ashleyjr/Motor/hw/prints/trials/20201205_flywheel/notes.txt

To print use 0.2 with 50 infill 60C bed heat.

This stops the part lifting at the edges.
