ashleyjr/Motor/hw/prints/trials/20201114_pinned_bearing/pinned_bearing.stl

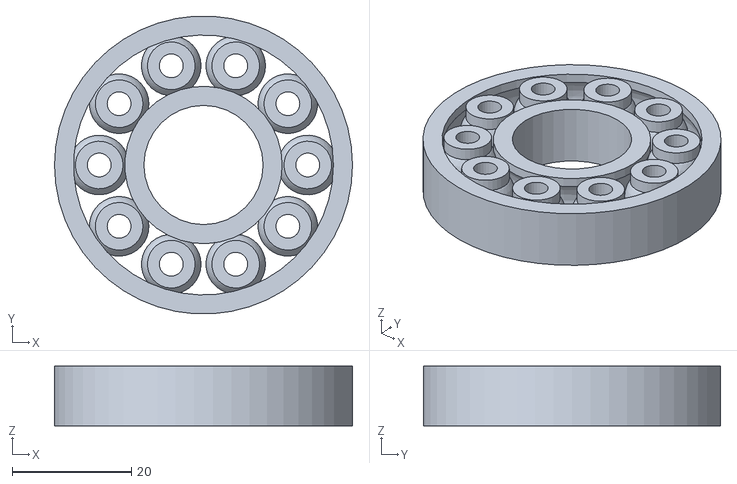
[picture p2: CAD file, 2020-11-15]
hw/prints/trials/20201114_pinned_bearing/pinned_bearing.stl
50.0 x 49.9 x 10.0
