ashleyjr/Motor/hw/prints/trials/20201115_hourglass_cups/hourglass_cups.stl

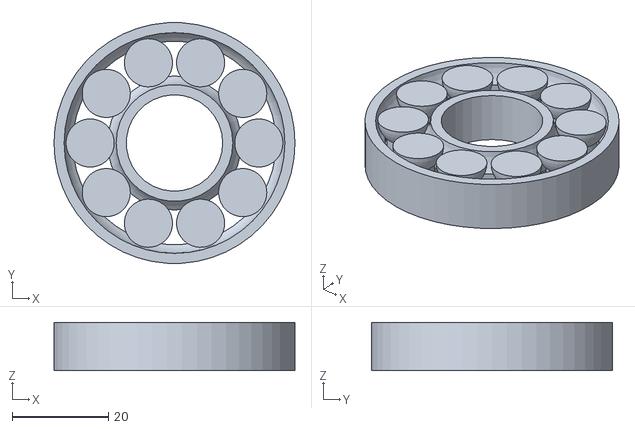
[picture p3: CAD file, 2020-11-16]
hw/prints/trials/20201115_hourglass_cups/hourglass_cups.stl
50.0 x 49.9 x 10.0
