ashleyjr/Motor/hw/prints/trials/20201117_grooves/grooves.stl

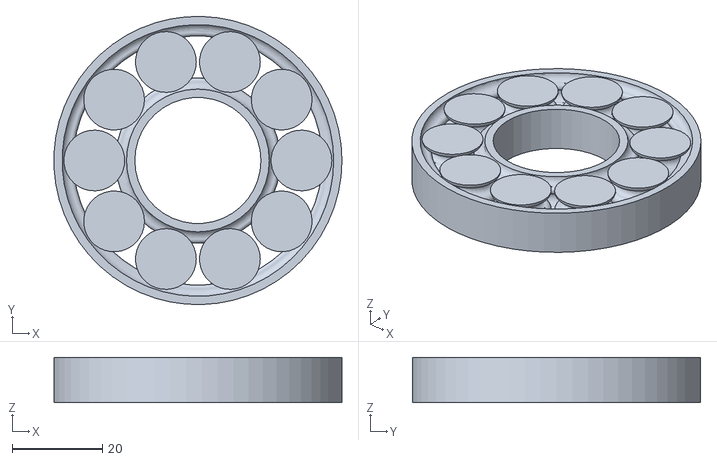
[picture p4: CAD file, 2020-11-19]
hw/prints/trials/20201117_grooves/grooves.stl
64.0 x 64.0 x 10.0
