ashleyjr/Motor/hw/prints/trials/20201119_shaft/shaft.stl

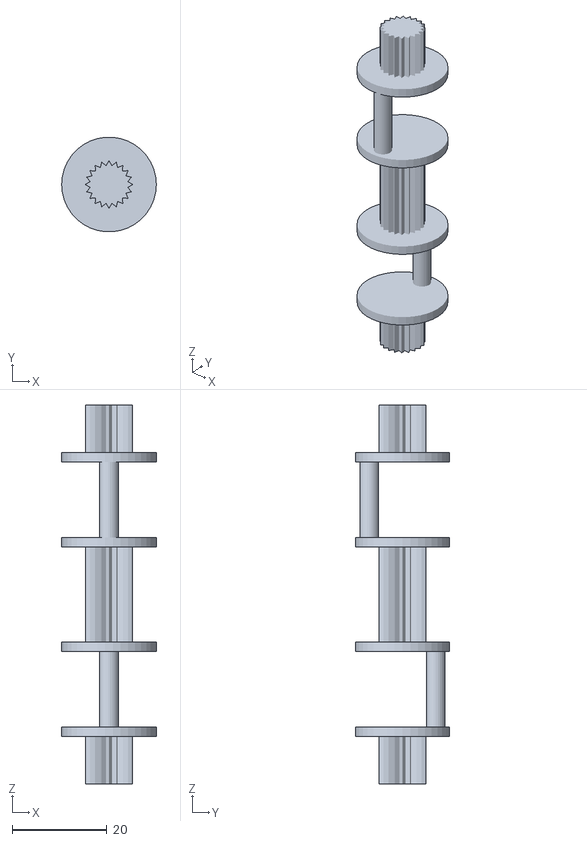
[picture p5: CAD file, 2020-11-20]
hw/prints/trials/20201119_shaft/shaft.stl
20.0 x 19.9 x 80.0
