ashleyjr/Motor/hw/prints/trials/20201121_hoop/hoop.stl

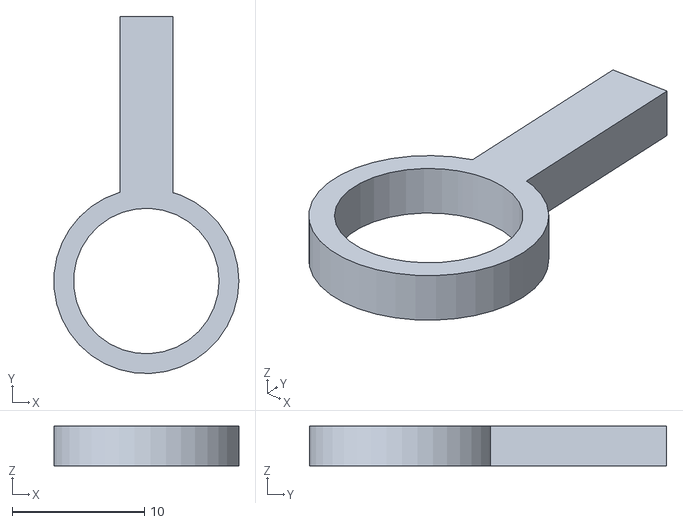
[picture p6: CAD file, 2020-11-21]
hw/prints/trials/20201121_hoop/hoop.stl
14.0 x 27.0 x 3.00
