ashleyjr/Motor/hw/prints/trials/20201121_locked_bearing/300um.stl

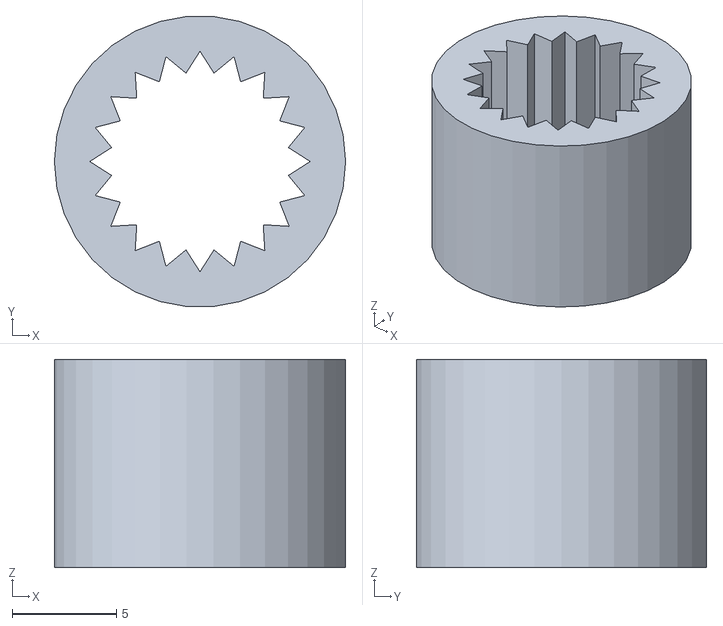
[picture p7: CAD file, 2020-11-21]
hw/prints/trials/20201121_locked_bearing/300um.stl
14.0 x 13.9 x 10.0
