ashleyjr/Motor/hw/prints/trials/20201121_sine_shaft/sine_shaft.stl

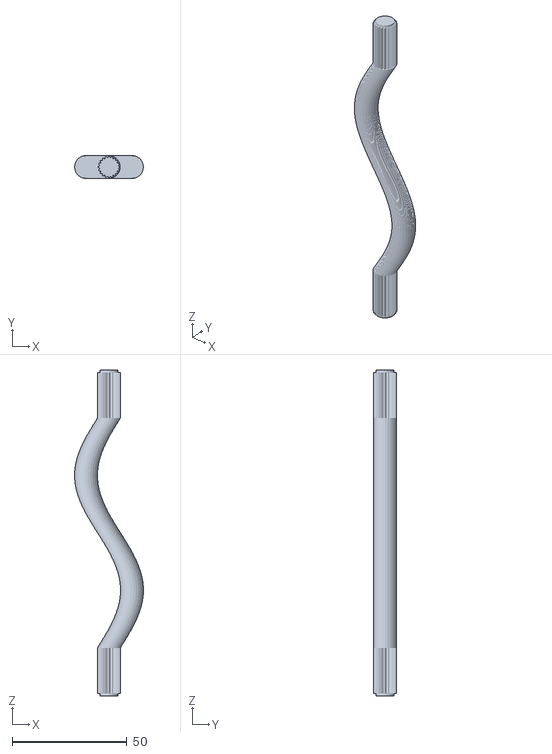
[picture p8: CAD file, 2020-12-08]
hw/prints/trials/20201121_sine_shaft/sine_shaft.stl
30.0 x 10.0 x 142.0
