ashleyjr/Motor/hw/prints/trials/20201123_side/side.stl

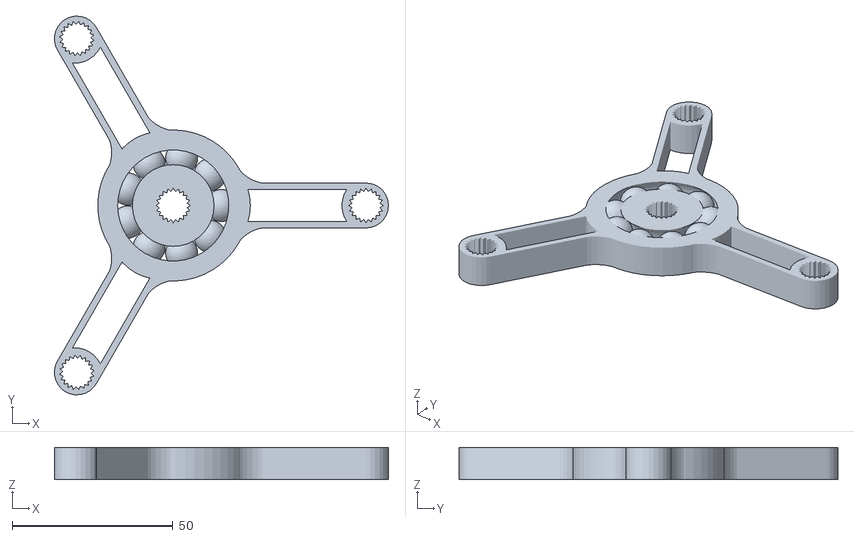
[picture p9: CAD file, 2020-12-02]
hw/prints/trials/20201123_side/side.stl
104.0 x 117.9 x 10.0
