ashleyjr/Motor/hw/prints/trials/20201125_shaft/shaft.stl

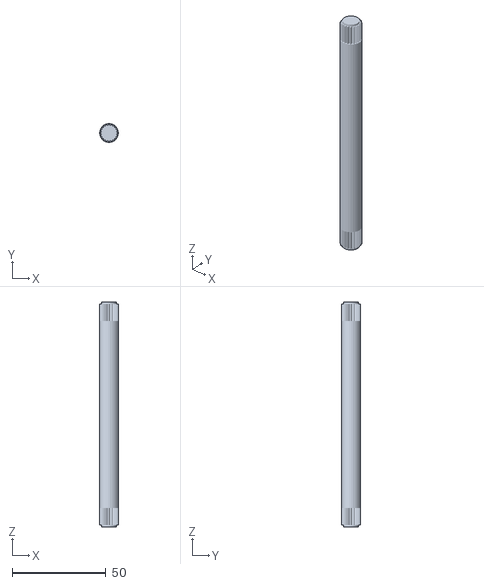
[picture p10: CAD file, 2020-11-25]
hw/prints/trials/20201125_shaft/shaft.stl
10.0 x 10.0 x 120.0
