ashleyjr/Motor/hw/prints/trials/20201127_solenoid/solenoid.stl

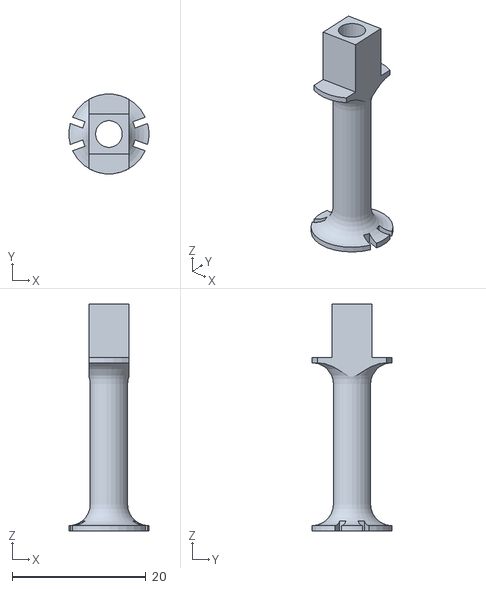
[picture p11: CAD file, 2020-12-07]
hw/prints/trials/20201127_solenoid/solenoid.stl
12.0 x 12.0 x 34.0
