ashleyjr/Motor/hw/prints/trials/20201129_hinge/hinge.stl

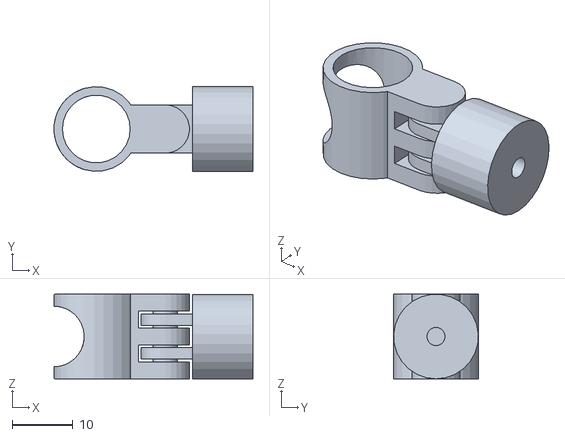
[picture p12: CAD file, 2020-12-10]
hw/prints/trials/20201129_hinge/hinge.stl
32.9 x 14.0 x 14.0
