ashleyjr/Motor/hw/prints/trials/20201201_crank/crank.stl

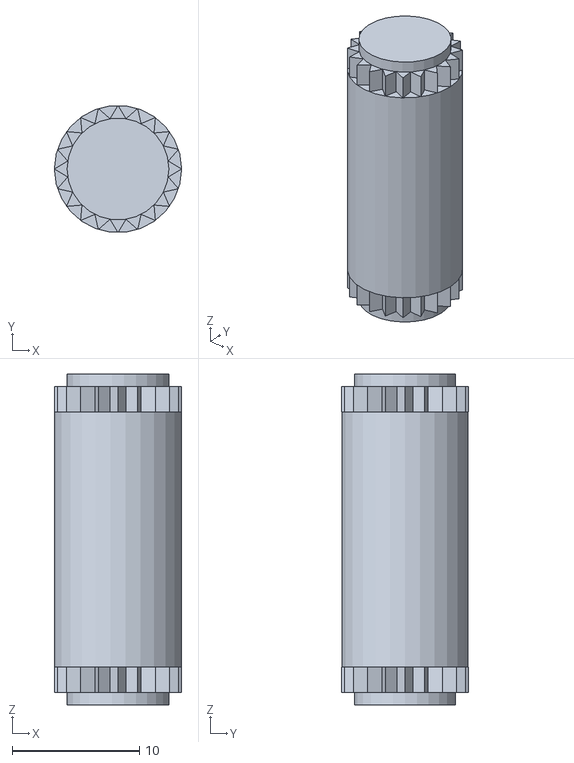
[picture p13: CAD file, 2020-12-01]
hw/prints/trials/20201201_crank/crank.stl
10.0 x 10.0 x 26.0
