ashleyjr/Motor/hw/prints/trials/20201201_crank_plate/crank_plate.stl

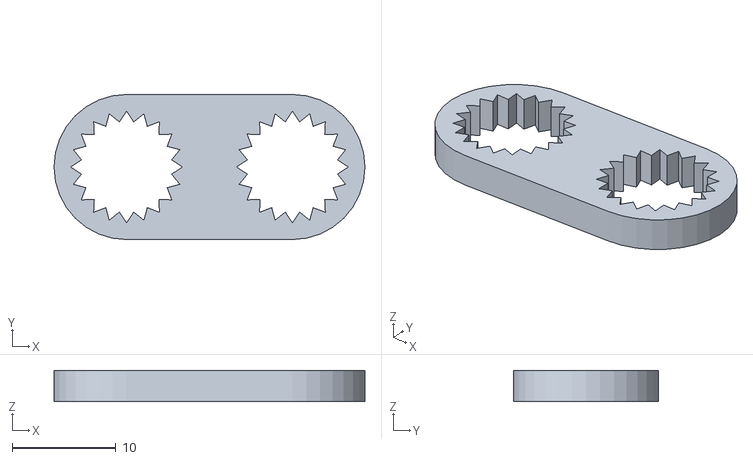
[picture p14: CAD file, 2020-12-01]
hw/prints/trials/20201201_crank_plate/crank_plate.stl
30.0 x 14.0 x 3.00
