ashleyjr/Motor/hw/prints/trials/20201202_top_shaft/top_shaft.stl

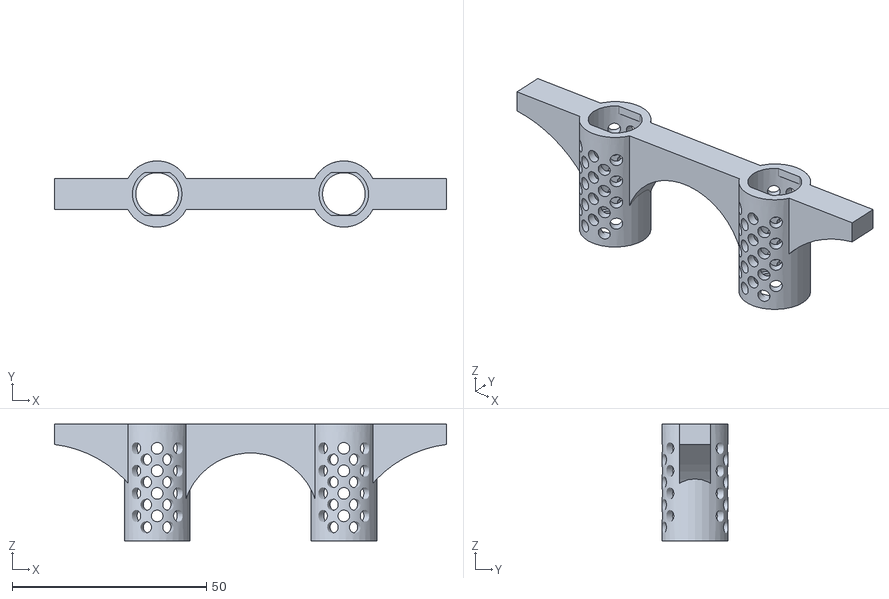
[picture p15: CAD file, 2020-12-07]
hw/prints/trials/20201202_top_shaft/top_shaft.stl
100.8 x 17.0 x 30.0
