ashleyjr/Motor/hw/prints/trials/20201205_flywheel/flywheel.stl

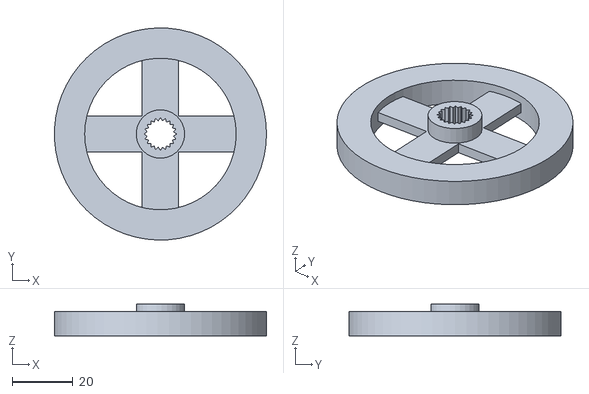
[picture p16: CAD file, 2020-12-10]
hw/prints/trials/20201205_flywheel/flywheel.stl
70.0 x 70.0 x 10.5
