ashleyjr/Motor/hw/prints/trials/20201207_holder/holder.stl

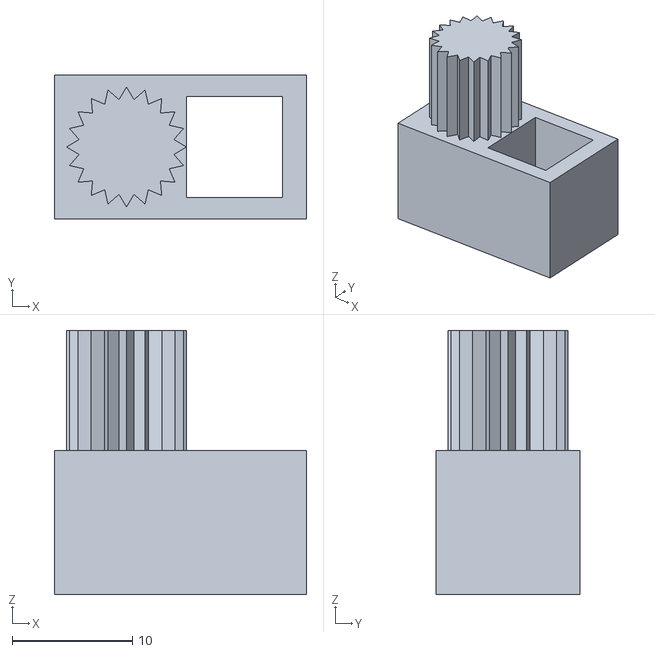
[picture p17: CAD file, 2020-12-08]
hw/prints/trials/20201207_holder/holder.stl
21.0 x 12.0 x 22.0
