ashleyjr/Motor/hw/prints/trials/20201112_bearing_gap/0250um.stl

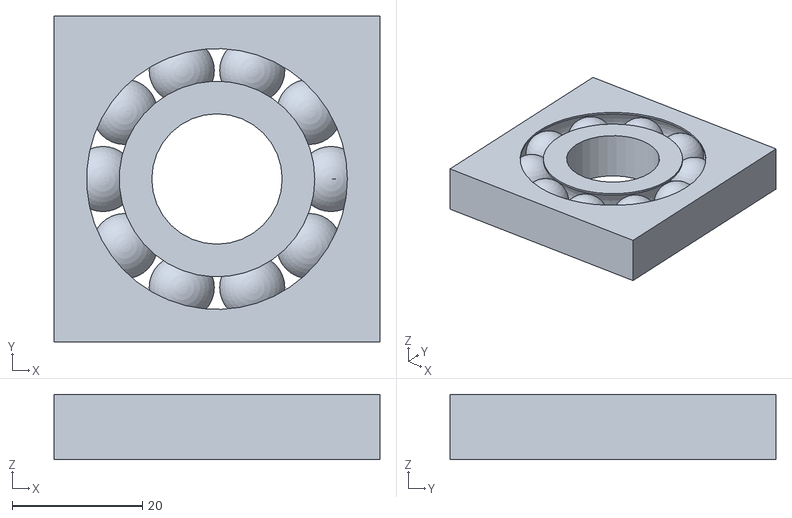
[picture p18: CAD file, 2020-11-12]
hw/prints/trials/20201112_bearing_gap/0250um.stl
50.0 x 50.0 x 10.0
