ashleyjr/Motor/hw/prints/trials/20201127_solenoid/2000um.stl

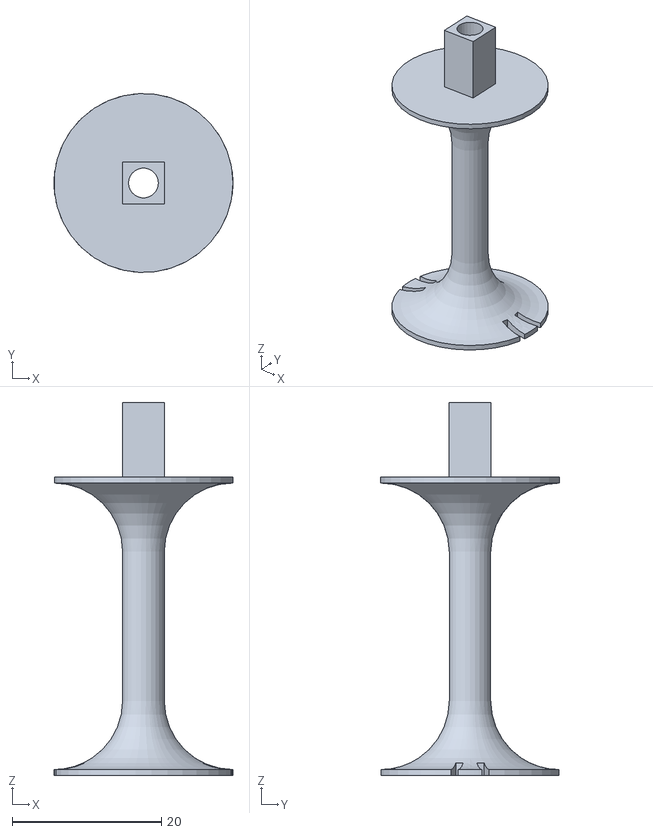
[picture p19: CAD file, 2020-12-01]
hw/prints/trials/20201127_solenoid/2000um.stl
24.0 x 24.0 x 50.0
