ashleyjr/Motor/(list of files, cad)

Other CAD files:
hw/prints/trials/20201116_rollers/rollers.stl
hw/prints/trials/20201116_track/track.stl
hw/prints/trials/20201121_locked_bearing/200um.stl
hw/prints/trials/20201112_bearing_gap/0500um.stl
hw/prints/trials/20201121_locked_bearing/100um.stl
hw/prints/trials/20201112_bearing_gap/0750um.stl
