ashleyjr/Motor/hw/prints/trials/20201129_hinge/notes.txt

-
   - Printed
 
      - Ender 5 Pro
      - PLA
      - 0.4mm nozzle
      - 0.12 Layer Height (high
      - 100% infill
      - No support
 
   - Outcome

      - Great print, hinges fine and the overhang is ok
      - Internal radius is too small for expected plunger so change to 5mm radius and try again
      - Prints well no in smaller size
         - Key to have about 3 layer between piston fins and shaft fins to the hinge does not get stuck
      
      - Tight piston end - could be tighter
      - Cut half cylinder out of front - could be smaller
