ashleyjr/Motor/hw/prints/trials/20201123_side/notes.txt

-
   - Printed
 
      - Ender 5 Pro
      - PLA
      - 0.4mm nozzle
      - 0.12 Layer Height (super)
      - 100% infill 
 
   - Outcome

      - Printed 0.12 at edge of bed but stared to lift away from the heated centre
      - Moved to middle of bed and 0.2 layer height (still 100% infill)

         - And change from Green (stringy) to black

      - Moved to 80 deg bed and printed wihtout lifting

         - Add fillets to edges
         - Make gaps bigger for stars
         - Make holes to save on print time
         - Printed 2 at 0.16, 100% with 80deg bed

      - Increased gap 
         
         - Try printy at 0.12
         - Also curved punches

      - Bearings dettached at 0.12 trying again at 0.16
      - Bearing still dettached so must be bearing gap
