ashleyjr/Motor/hw/prints/trials/20201125_shaft/notes.txt

-
   - Printed
 
      - Ender 5 Pro
      - PLA
      - 0.4mm nozzle
      - 0.28 Layer Height (low)
      - 100% infill 
 
   - Outcome

      - Good print
      - The lift works well and fits inside the side correctly
