ashleyjr/Motor/hw/prints/trials/20201121_hoop/notes.txt

-
   - Printed
 
      - Ender 5 Pro
      - PLA
      - 0.4mm nozzle
      - 0.12 Layer Height (super)
      - 100% infill
      - No support 
 
   - Outcome

      - Quick print
      - Fit well on shaft
      - Could round insude edges to stop catching
