ashleyjr/Motor/hw/prints/trials/20201121_locked_bearing/notes.txt

-
   - Printed
 
      - Ender 5 Pro
      - PLA
      - 0.4mm nozzle
      - 0.12 Layer Height (super)
      - 100% infill
      - No support 
 
   - Outcome

      - Position on bed
      -   O       O      O
      -   100um   200um  300um
     
      - Not chance of getting 100 or 200 on with current print of sine shaft lock
      - 300 goes on with a tight fit, very nice
      - Could put in a small channel for glue
