ashleyjr/Motor/hw/prints/trials/20201121_sine_shaft/notes.txt

-
   - Printed
 
      - Ender 5 Pro
      - PLA
      - 0.4mm nozzle
      - 0.12 Layer Height (super)
      - 100% infill
      - no support
 
   - Outcome

      - Lock section prints nicely
      - With no support began to wibble at just over half way
      - Change to have support from 10deg overhang but only touching buildplate
      - Prints very well with supports, lock nearest the bed is a bit scrappy
