ashleyjr/Motor/hw/prints/trials/20201116_track/notes.txt

-
   - Printed
 
      - Ender 5 Pro
      - PLA
      - 0.4mm nozzle
      - 0.12 Layer Height (super quality)
      - 100% infill
      - No support material!!
      - No adhesion, just skirt
 
   - Outcome

      - Support material was to small to stick
      - Without support unable to print
      - Deadend
