ashleyjr/Motor/hw/prints/trials/20201115_hourglass_cups/notes.txt

   - Printed
 
      - Ender 5 Pro
      - PLA
      - 0.4mm nozzle
      - 0.12 Layer Height (super quality)
      - 100% infill
      - No support material!!
      - No adhesion, just skirt
 
   - Outcome

      - First print run failed, looks random, re-adjusted bed and started again
      - Bearings fell out on first turn, print was ok but too loose
      - Updated print reducing gap between bearings and rotor/house to 200um and also the diamter of the 
        pins to further lock in the cups
      - Gap too tight for rotation, increse to 400um
