ashleyjr/Motor/(commit log)

2020-11-12 bearing gap trial
    [0250um.stl, 0500um.stl, 0750um.stl, 1000um.stl]
2020-11-14 Pinned bearing test
    [pinned_bearing.stl]
2020-11-14 Notes bearing gap
2020-11-15 Pinned bearings update
    [pinned_bearing.stl]
2020-11-15 Hourglass cups
    [hourglass_cups.stl]
2020-11-15 Update hourglass cups print
    [hourglass_cups.stl]
2020-11-16 200um gap to 400um
    [hourglass_cups.stl]
2020-11-16 roller trial
    [rollers.stl]
2020-11-21 sine shaft
    [sine_shaft.stl]
2020-11-21 Locked bearings
    [100um.stl, 200um.stl, 300um.stl]
2020-11-24 Side trial
    [side.stl]
2020-11-25 thin prongs and cut out
2020-11-25 added fillet
    [side.stl]
2020-11-25 straight shaft
    [shaft.stl]
2020-12-01 wide rod
    [2000um.stl, hinge.stl, solenoid.stl]
2020-12-01 more test prints
    [hinge.stl, solenoid.stl]
2020-12-01 crank section
    [crank.stl]
2020-12-01 crank plate
    [crank.stl, crank_plate.stl]
2020-12-02 side updates
    [side.stl]
2020-12-02 top shaft buckets
    [top_shaft.stl]
2020-12-03 solenoid experiment
    [solenoid.stl]
2020-12-03 solenoid updates
    [solenoid.stl]
2020-12-04 solenoid and top shaft
    [solenoid.stl, top_shaft.stl]
2020-12-07 hinge updates
    [hinge.stl]
2020-12-07 added solenoid holders
    [top_shaft.stl]
2020-12-07 more solenoid
    [solenoid.stl]
2020-12-08 added holders
    [holder.stl]
2020-12-08 smaller flywheel
    [flywheel.stl]
2020-12-08 extend sine shaft lock
    [sine_shaft.stl]
2020-12-08 wider flywheel
    [flywheel.stl]
2020-12-10 flythweel tune up
    [flywheel.stl]
2020-12-10 adjust hinge
    [hinge.stl]
2020-12-10 leds working
2020-12-10 uart working
